demianbadin/Ghettostation/Mega2560-Schematic.png

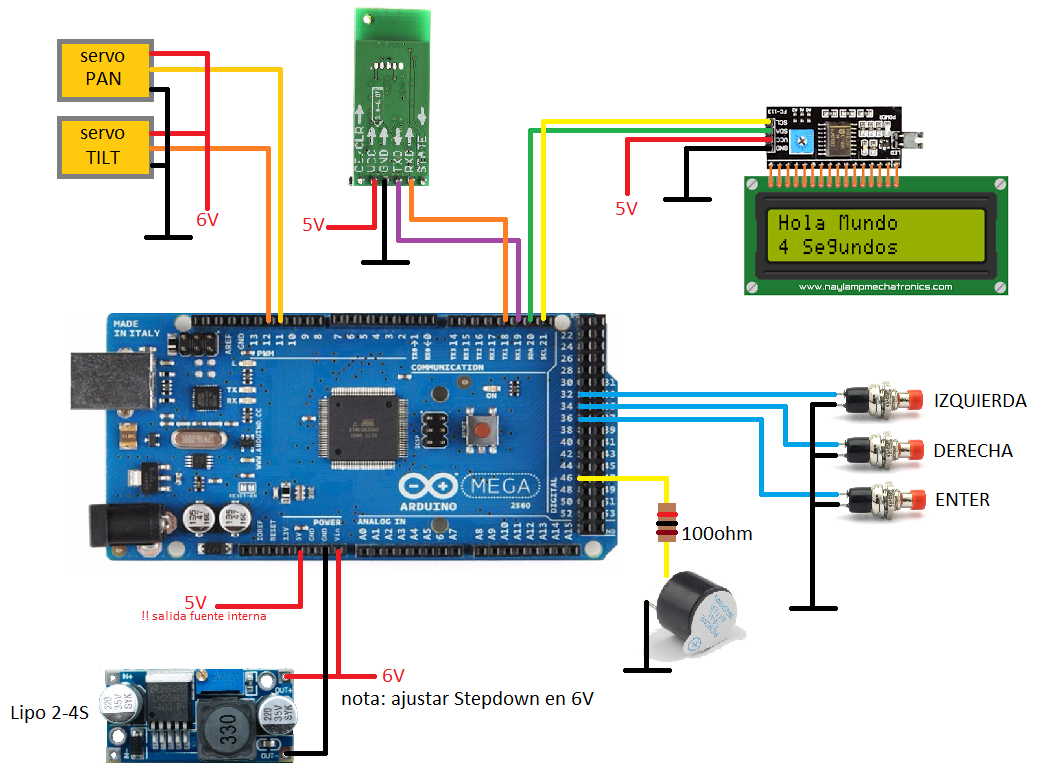
Mega2560-Schematic.png
