demianbadin/Ghettostation/New_case_3D.jpg

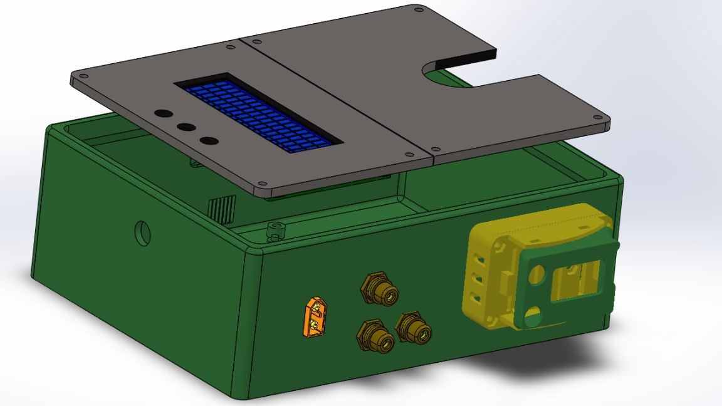
New_case_3D.jpg
