demianbadin/Ghettostation/Docs/Bluetooth.png

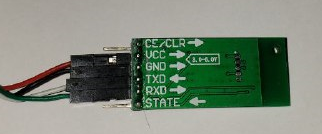
Docs/Bluetooth.png
