demianbadin/Ghettostation/Docs/R9M bluetooth circuit.jpg

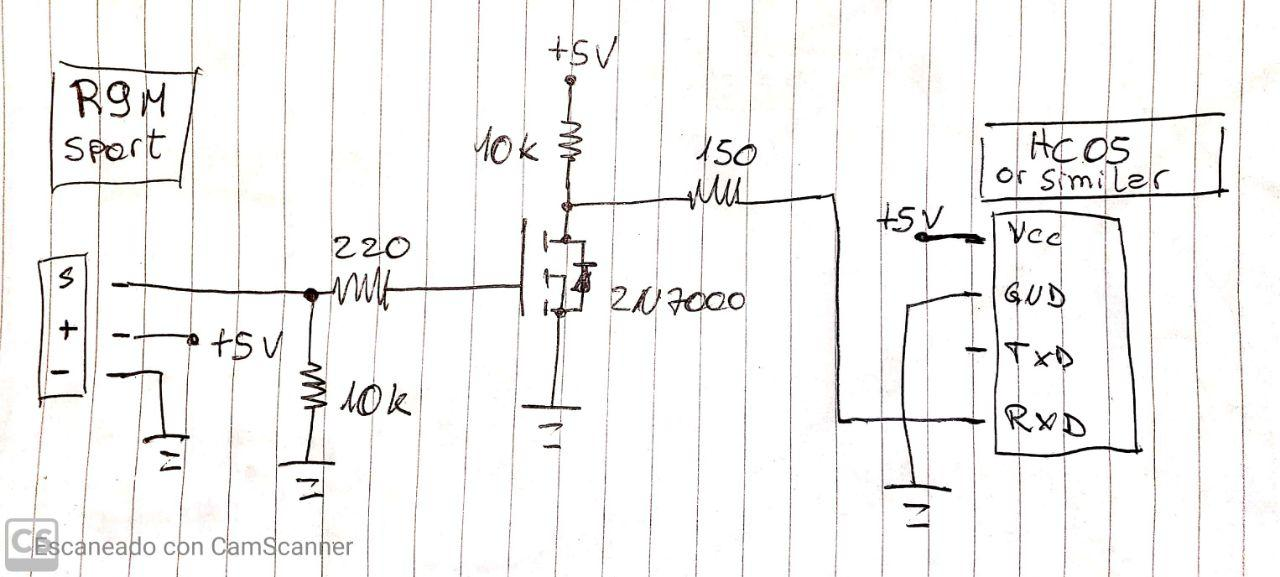
Docs/R9M bluetooth circuit.jpg
