demianbadin/Ghettostation/Docs/R9M bluetooth mod.jpg

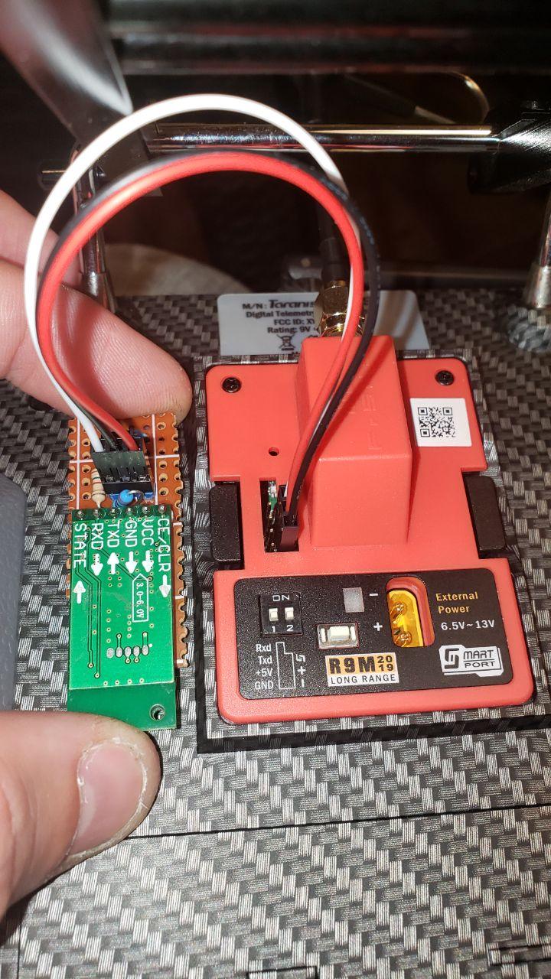
Docs/R9M bluetooth mod.jpg
