demianbadin/Ghettostation/Docs/XM-15B.jpg

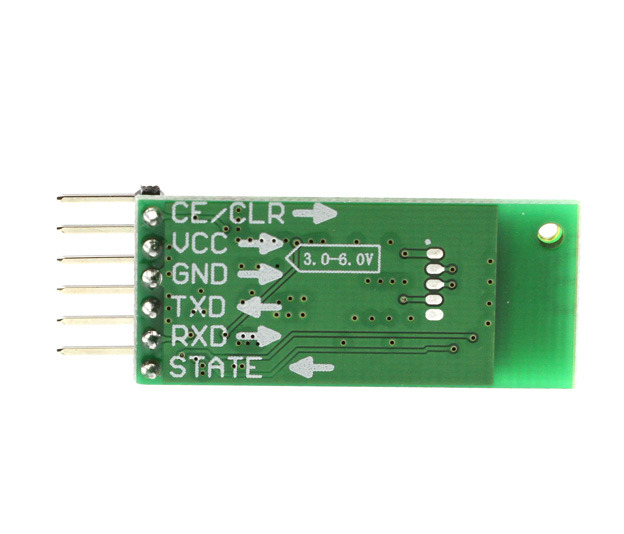
Docs/XM-15B.jpg
