demianbadin/Ghettostation/GhettoStation/Lcd.ino

//LCD 

void init_lcdscreen() {
#ifdef DEBUG
    Serial.println("starting lcd"); 
#endif

  read_voltage();
  char extract[20];

// init LCD
#ifdef OLEDLCD
  display.setTextSize(1);
  display.setTextColor(WHITE);
  display.setCursor(0,0);
  display.println(string_load1.copy(extract));
  display.println(string_load2.copy(extract));
  display.println(string_load3.copy(extract));
  char currentline[21];
  char bufferV[6];
  sprintf(currentline,"Battery: %s V", dtostrf(voltage_actual, 4, 2, bufferV));
  display.println(currentline);
  display.display();
  delay(2500); //delay to init lcd in time.
  display.clearDisplay();
#else

#ifdef GLCDEnable
    GLCD.Init(NON_INVERTED);
    GLCD.SelectFont(System5x7);
    LCD.begin(20,4); // No idea why this is still needed for GLCD, but it breaks without
    GLCD.CursorTo(0,0);
    GLCD.println(string_load1.copy(extract));
    GLCD.println(string_load2.copy(extract));
    GLCD.println(string_load3.copy(extract));
    char currentline[21];
    char bufferV[6];
    sprintf(currentline,"Battery: %s V", dtostrf(voltage_actual, 4, 2, bufferV));
    GLCD.println(currentline);
    delay(1500); //delay to init lcd in time.

#else
    LCD.begin(20,4);
        delay(20);
    LCD.backlight();        
    	delay(250);         
    LCD.noBacklight();      
    	delay(250);
    LCD.backlight(); 
        delay(250);
    LCD.setCursor(0,0);
    LCD.print(string_load1.copy(extract));
    LCD.setCursor(0,1);
    LCD.print(string_load2.copy(extract));
    LCD.setCursor(0,2);
    LCD.print(string_load3.copy(extract));
    LCD.setCursor(0,3);
    	char currentline[21];
    	char bufferV[6];
    	sprintf(currentline,"Battery: %s V", dtostrf(voltage_actual, 4, 2, bufferV));
    LCD.print(currentline);
    	delay(1500); //delay to init lcd in time.
#endif
#endif
}

void store_lcdline( int i, char sbuffer[20] ) {
    
    switch (i) {
        case 1: 
                strcpy(lcd_line1,sbuffer);
                break;
        case 2: 
                strcpy(lcd_line2,sbuffer);
                break;
        case 3: 
                strcpy(lcd_line3,sbuffer);
                break;
        case 4: 
                strcpy(lcd_line4,sbuffer);
                break;
        default: 
                break;
    }

}

void refresh_lcd() {
// refreshing lcd at defined update.
// update lines

#ifdef OLEDLCD
        display.clearDisplay();
        display.setCursor(0,0);
        display.println(lcd_line1);
    	display.println(lcd_line2);
    	display.println(lcd_line3);
        display.println(lcd_line4);
        display.display();
        delay(100);
#endif

#ifdef GLCDEnable
       	GLCD.CursorTo(0,0);
	GLCD.println(lcd_line1);
    	GLCD.println(lcd_line2);
    	GLCD.println(lcd_line3);
        GLCD.println(lcd_line4);
#else
	LCD.setCursor(0,0);
	LCD.print(lcd_line1);
        LCD.setCursor(0,1);
    	LCD.print(lcd_line2);
        LCD.setCursor(0,2);
    	LCD.print(lcd_line3);
        LCD.setCursor(0,3);
        LCD.print(lcd_line4);
#endif
}

void lcddisp_menu() {
    Menu const* displaymenu_current = displaymenu.get_current_menu();
    MenuComponent const* displaymenu_sel = displaymenu_current->get_selected();
    
    uint8_t selected_item;
    uint8_t menu_components_number;
    uint8_t m;
    selected_item = displaymenu_current->get_cur_menu_component_num();
    menu_components_number = displaymenu_current->get_num_menu_components();  
    for (int n = 1; n < 5 ; n++)  {      
        char currentline[21];
        if ( menu_components_number >= n ) {
            if (menu_components_number <= 4)
                m = n; 
            else if (selected_item < (menu_components_number - selected_item - 1))
                m =  selected_item + n ;
            else 
                m =  menu_components_number - (menu_components_number - n - 1);
            MenuComponent const* displaymenu_comp = displaymenu_current->get_menu_component(m - 1);
            sprintf(currentline,displaymenu_comp->get_name());
            for ( int l = strlen(currentline); l<19 ; l++ ) {
                strcat(currentline," ");
            }             
            if (displaymenu_sel == displaymenu_comp) 
                strcat(currentline,"<");
            else 
                strcat(currentline," ");
         }
         else {
             string_load2.copy(currentline);
         }
         store_lcdline(n, currentline);
    }
}


// SET_HOME SCREEN
void lcddisp_sethome() {
    for ( int i = 1 ; i<5; i++ ) {
        char currentline[21] = "";
        char extract[21];
        switch (i) {
            case 1:
                //line1
                if (!telemetry_ok) { 
                    strcpy(currentline, "P:NO TELEMETRY"); }
                else if (telemetry_ok) { 
                    sprintf(currentline,"P:%s SATS:%d FIX:%d", protocol, uav_satellites_visible, uav_fix_type);
                }
                break;
            case 2:
                //line 2
                if (!telemetry_ok) 
                    string_shome1.copy(currentline); // waiting for data
                else 
                {
                    if (!gps_fix)
                        string_shome2.copy(currentline);  // waiting for gps fix
                    else {
                        sprintf(currentline, "%s%dm",string_shome3.copy(extract),(int)round(uav_alt/100.0f));    
                    }
                }
                break;
      
            case 3:
                if (!gps_fix) strcpy(currentline, string_shome4.copy(extract));
                    else {
                        char bufferl[10];
                        char bufferL[10];
                        sprintf(currentline,"%s %s", dtostrf(uav_lat/10000000.0, 5, 5, bufferl),dtostrf(uav_lon/10000000.0, 5, 5, bufferL));
                    }
                break;
            case 4:
                if (!gps_fix) 
                    strcpy(currentline,string_shome5.copy(extract));
                else 
                    string_shome6.copy(currentline);
                break;
            }
 
        for ( int l = strlen(currentline); l<20 ; l++ )
            strcat(currentline," ");
        store_lcdline(i,currentline);
    }  
}

void lcddisp_setbearing() {
    switch (configuration.bearing_method) {
        case 2:
            if (right_button.holdTime() >= 700 && right_button.isPressed() ) {
                home_bearing+=10;
                if (home_bearing > 359) 
                    home_bearing = 0;
                delay(500);
                }
            else if ( left_button.holdTime() >= 700 && left_button.isPressed() ) {
                home_bearing-=10;
                if (home_bearing < 0) 
                    home_bearing = 359;
                delay(500);   
            }
            break;
        case 3:
            home_bearing = uav_heading;  // use compass data from the uav. 
            break;
        case 4:
            retrieve_mag();
            break;
        default:
            break;
    }
    for (int i = 1 ; i<5; i++) {            
        char currentline[21] = "";
        char extract[21];
        switch (i) {
            case 1: 
                if (!telemetry_ok) 
                {
                    strcpy(currentline,"P:NO TELEMETRY"); 
                }
                else if (telemetry_ok)
                    sprintf(currentline,"P:%s SATS:%d FIX:%d", protocol, uav_satellites_visible, uav_fix_type); 
                break;
            case 2:
               if (configuration.bearing_method == 1) 
                   string_load2.copy(currentline);  
               else
                   string_shome7.copy(currentline);
               break;
            case 3:
                if (configuration.bearing_method == 1)
                    string_shome8.copy(currentline);
                else if (configuration.bearing_method == 2)
                    sprintf(currentline, "     << %3d >>", home_bearing);
                else
                    sprintf(currentline, "        %3d   ", home_bearing);
                break;     
            case 4:      
                string_shome9.copy(currentline); break;
            default:
                break;
    
       }
       for ( int l = strlen(currentline); l<20 ; l++ ) {
           strcat(currentline," ");
       }
       store_lcdline(i,currentline);
    }
}

void lcddisp_homeok() {
    for ( int i = 1 ; i<5; i++ ) {
       char currentline[21] = "";
       switch (i) {
            case 1: 
                if (!telemetry_ok) { strcpy(currentline, "P:NO TELEMETRY"); }
                else if (telemetry_ok) sprintf(currentline,"P:%s SATS:%d FIX:%d", protocol, uav_satellites_visible, uav_fix_type);
                break;
            case 2:
                string_shome10.copy(currentline); break;
            case 3:
                string_shome11.copy(currentline); break;                
            case 4:
                string_shome12.copy(currentline); break;
            }
        for ( int l = strlen(currentline); l<20 ; l++ ) {
            strcat(currentline," ");
        }
    store_lcdline(i,currentline);
    }
}

void lcddisp_tracking(){
    for ( int i = 1 ; i<5; i++ ) {
        char currentline[21]="";
        switch (i) {
            case 1: 
                if (!telemetry_ok)
                    strcpy(currentline, "P:NO TELEMETRY");
                else if (telemetry_ok) 
                    sprintf(currentline,"P:%s SATS:%d FIX:%d", protocol, uav_satellites_visible, uav_fix_type);
                break;
           case 2:
                sprintf(currentline, "Alt:%dm Spd:%d", (int)round(rel_alt/100.0f), uav_groundspeed);
                break;
           case 3:
                sprintf(currentline, "Dist:%dm Hdg:%d", (int)round(home_dist/100.0f), uav_heading);
                break;
           case 4:   
                char bufferl[10];
                char bufferL[10];
                sprintf(currentline,"%s %s", dtostrf(uav_lat/10000000.0, 5, 5, bufferl),dtostrf(uav_lon/10000000.0, 5, 5, bufferL));
                break;
        }
        for ( int l = strlen(currentline); l<20 ; l++ ) {
        strcat(currentline," ");
        }
        store_lcdline(i,currentline);
    }
}

void lcddisp_telemetry() {
    for ( int i = 1 ; i<5; i++ ) {
        char currentline[21]="";
        char extract[21];
        switch (i) {
            case 1: 
                string_telemetry1.copy(currentline);  break;
            case 2:
                string_load2.copy(currentline);  break;
            case 3:
                switch (configuration.telemetry) {
                     case 0:
                        // currentline = "UAVTalk"; break;
                        string_telemetry2.copy(currentline); break;
                    case 1:
                         //currentline = "MSP"; break;
                        string_telemetry3.copy(currentline); break;
                    case 2:
                        //currentline = "LTM"; break;
                        string_telemetry4.copy(currentline); break;
                    case 3:
                        //currentline = "MavLink"; break;
                        string_telemetry5.copy(currentline); break;
                    case 4:
                        //currentline = "NMEA"; break;
                        string_telemetry6.copy(currentline); break;
                    case 5:
                        //currentline = "UBLOX"; break;
                        string_telemetry7.copy(currentline); break;
                    case 6:
                        //currentline = "SPORT"; break;
                        string_telemetry8.copy(currentline); break;                     
                     }
                     break;
            case 4:      
                strcpy(currentline, string_shome5.copy(extract)); break;

        }
        for ( int l = strlen(currentline); l<20 ; l++ )
            strcat(currentline," ");
        store_lcdline(i,currentline);
    }
  
}

void lcddisp_baudrate() {
    for ( int i = 1 ; i<5; i++ ) {
        char currentline[21]="";
        char extract[21];
        switch (i) {
            case 1: 
                string_baudrate.copy(currentline);  break;
            case 2:
                strcpy(currentline, string_load2.copy(extract)); break;
            case 3:
                switch (configuration.baudrate) {            
                    case 0:
                        // 1200
                        string_baudrate0.copy(currentline);  break;
                    case 1:
                        //2400
                        string_baudrate1.copy(currentline);  break;
                    case 2:
                        //4800
                        string_baudrate2.copy(currentline); break;
                    case 3:
                        //9600
                        string_baudrate3.copy(currentline);  break;
                    case 4:
                        //19200
                       string_baudrate4.copy(currentline);  break;
                    case 5:
                        //38400
                       string_baudrate5.copy(currentline);  break;
                    case 6:
                        //57600
                       string_baudrate6.copy(currentline);  break;
                    case 7:
                       //115200
                       string_baudrate7.copy(currentline);  break;                                                            
                    }
                    break;
            case 4:      
                    string_shome5.copy(currentline); break;
            }
        for ( int l = strlen(currentline); l<20 ; l++ ) {
        strcat(currentline," ");
        }
    store_lcdline(i,currentline);
    }
}

// Settings Bank config
void lcddisp_bank() {
    for ( int i = 1 ; i<5; i++ ) {
       char currentline[21]="";
       char extract[21];
       switch (i) {
            case 1: 
               string_bank.copy(currentline);  break;
            case 2:
               string_load2.copy(currentline); break;
            case 3:
               switch (current_bank+1) {
                   case 1: sprintf(currentline,"> %s", string_bank1.copy(extract));break;
                   case 2: sprintf(currentline,"> %s", string_bank2.copy(extract));break;
                   case 3: sprintf(currentline,"> %s", string_bank3.copy(extract));break;
                   case 4: sprintf(currentline,"> %s", string_bank4.copy(extract));break;
                }
                break;
            case 4:      
                string_shome5.copy(currentline); break;
        }
        for ( int l = strlen(currentline); l<20 ; l++ ) {
            strcat(currentline," ");
        }
        store_lcdline(i,currentline);
    }
}


void lcddisp_bearing_method() {
    for ( int i = 1 ; i<5; i++ ) {
        char currentline[21]="";
        char extract[21];
        switch (i) {
            case 1: 
                string_bearing0.copy(currentline);  break;
            case 2:
                string_load2.copy(currentline);  break;
            case 3:
                switch (configuration.bearing_method) {
                    case 1:
                        //currentline = "MSP"; break;
                        string_bearing1.copy(currentline); break;
                    case 2:
                        //currentline = "LTM"; break;
                        string_bearing2.copy(currentline); break;
                    case 3:
                        //currentline = "MavLink"; break;
                        string_bearing3.copy(currentline); break;
                    case 4:
                        //currentline = "NMEA"; break;
                        string_bearing4.copy(currentline); break;
                }
                break;
            case 4:      
                strcpy(currentline, string_shome5.copy(extract)); break;
        }
        for ( int l = strlen(currentline); l<20 ; l++ ) {
            strcat(currentline," ");
        }
        store_lcdline(i,currentline);
    } 
}


void lcddisp_voltage_ratio() {
    read_voltage();
    if (right_button.holdTime() >= 700 && right_button.isPressed() ) {
              voltage_ratio += 10;
              delay(500);
        }
        else if ( left_button.holdTime() >= 700 && left_button.isPressed() ) {
              voltage_ratio -= 10;
              delay(500);
        }
    for ( int i = 1 ; i<5; i++ ) {
        char currentline[21]="";
        char extract[21];
        switch (i) {
            case 1: 
                string_voltage0.copy(currentline);  break;
            case 2:
                char bufferV[6];
                sprintf(currentline,"Voltage: %s V", dtostrf(voltage_actual, 4, 2, bufferV));
                break;
            case 3:
                char bufferX[5];
                sprintf(currentline,"Ratio:  %s ", dtostrf(voltage_ratio, 3, 2, bufferV));
                break;
            case 4:      
                strcpy(currentline, string_shome5.copy(extract));  break;
        }
        for ( int l = strlen(currentline); l<20 ; l++ ) {
            strcat(currentline," ");
        }
        store_lcdline(i,currentline);
    } 
}

void lcddisp_testservo() {
    for ( int i = 1 ; i<5; i++ ) {
        char currentline[21]="";
        char extract[21];
        switch (i) {
            case 1: 
                string_servos3.copy(currentline);  break;
            case 2:
                string_servos4.copy(currentline); break;
            case 3:
                string_load2.copy(currentline); break;     
            case 4:      
                string_shome5.copy(currentline); break;
        }
        for ( int l = strlen(currentline); l<20 ; l++ ) {
            strcat(currentline," ");
        }
        store_lcdline(i,currentline);
    }
}

// SERVO CONFIGURATION

int config_servo(int servotype, int valuetype, int value ) {
    // servo configuration screen function return configured value
        //check long press left right
        if (right_button.holdTime() >= 700 && right_button.isPressed() ) {
              value+=20;
              delay(500);
        }
        else if ( left_button.holdTime() >= 700 && left_button.isPressed() ) {
              value-=20;
              delay(500);
        }
        char currentline[21];
        char extract[21];
    if (servotype==1) {
        string_servos1.copy(currentline);                              // Pan servo
        store_lcdline(1, currentline);
    }
    else if (servotype==2) {
        string_servos2.copy(currentline);                              // Tilt servo
        store_lcdline(1, currentline);
    }
    string_load2.copy(currentline);
        store_lcdline(2, currentline);
    switch (valuetype) 
    {           
        case 1: sprintf(currentline, "min endpoint: <%4d>",  value); break;          //minpwm
        case 2: sprintf(currentline, "min angle: <%3d>    ", value); break;         //minangle
        case 3: sprintf(currentline, "max endpoint: <%4d>",  value); break;          //maxpwm
        case 4: sprintf(currentline, "max angle: <%3d>    ", value); break;         //maxangle
    }
    store_lcdline(3, currentline);
    string_shome5.copy(currentline);
    store_lcdline(4, currentline); 
    return value;
           
}
