demianbadin/Ghettostation/(commit log)

2019-06-07 nuevo esquema cableadoi Mega2560
2019-06-07 nuevo esquema cableado Mega2560
2019-06-09 agregado hardware Arduino UNO
2020-04-19 Modificado el circuito bluetooth del R9M ya que el anetrior traia errores en la telemetría.
    [Config.h, GhettoStation.h, GhettoStation.ino, Lcd.ino, LightTelemetry.cpp, frsky_sport.cpp]
2020-04-20 agregada dirección LCD I2C
